SaintGimp/UselessBox/UselessBox.brd

## EAGLE design UselessBox.brd (2015-03-20)

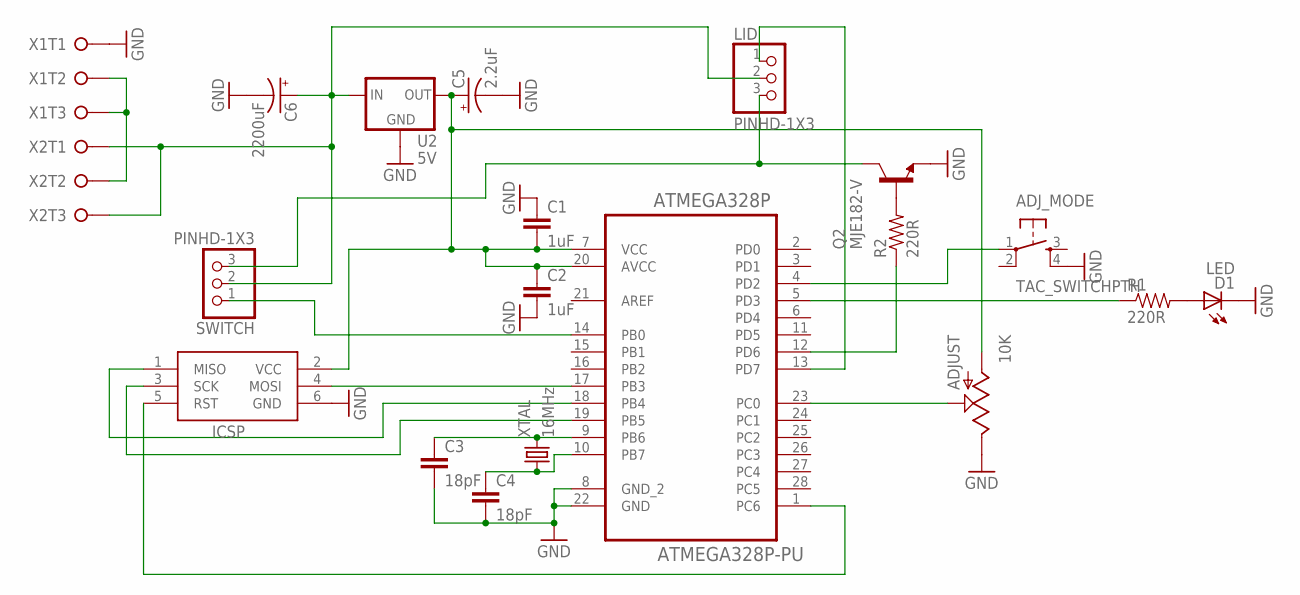
[picture p1: schematic UselessBox.sch]

Parts:
ADJUST: 10K; POT-3362U
ADJ_MODE: TAC_SWITCHPTH; TACTILE-SWITCH-6MM
ATMEGA328P: ATMEGA328P-PU; DIP28
C1, C2: 1uF; CAPACITOR-5MM
C3, C4: 18pF; CAPACITOR-2.5MM
C5: 2.2uF; CAP-POL-2.5-5
C6: 2200uF; CAP-POL-5-10
D1: LED; LED5MM
ICSP: AVRISP-6; AVRISP
LID: PINHD-1X3; 1X03
Q2: MJE182-V; TO225AA-V
R1, R2: 220R; AXIAL-7.5MM
SWITCH: PINHD-1X3; 1X03
U2: 5V; TO92-INLINE
X1, X2: SCREW-TERM-3
XTAL: 16MHz; CRYSTAL-V

Connections:
GND: ADJUST.P$1 (E), ADJ_MODE.4, ATMEGA328P.8 (GND_2), ATMEGA328P.22 (GND), C1.1, C2.2, C3.2, C4.2, C5.-, C6.-, D1.K (C), ICSP.6 (GND), Q2.E, U2.2 (GND), X1.1
unnamed: ATMEGA328P.13 (PD7), LID.1
unnamed: ADJ_MODE.1, ATMEGA328P.4 (PD2)
unnamed: ATMEGA328P.19 (PB5), ICSP.3 (SCK)
unnamed: ATMEGA328P.18 (PB4), ICSP.1 (MISO)
unnamed: ATMEGA328P.17 (PB3), ICSP.4 (MOSI)
unnamed: ATMEGA328P.1 (PC6), ICSP.5 (RST)
unnamed: ATMEGA328P.14 (PB0), SWITCH.1
unnamed: ATMEGA328P.9 (PB6), C3.1, XTAL.2
unnamed: ATMEGA328P.10 (PB7), C4.1, XTAL.1
unnamed: ATMEGA328P.12 (PD6), R2.P$1 (1)
unnamed: LID.3, Q2.C, SWITCH.3
unnamed: X1.2, X1.3, X2.2
unnamed: ADJUST.P$2 (S), ATMEGA328P.23 (PC0)
unnamed: Q2.B, R2.P$2 (2)
unnamed: D1.A, R1.P$2 (2)
unnamed: ATMEGA328P.5 (PD3), R1.P$1 (1)
VCC: ADJUST.P$3 (A), ATMEGA328P.7 (VCC), ATMEGA328P.20 (AVCC), C1.2, C2.1, C5.+, ICSP.2 (VCC), U2.1 (OUT)
VIN: C6.+, LID.2, SWITCH.2, U2.3 (IN), X2.1, X2.3

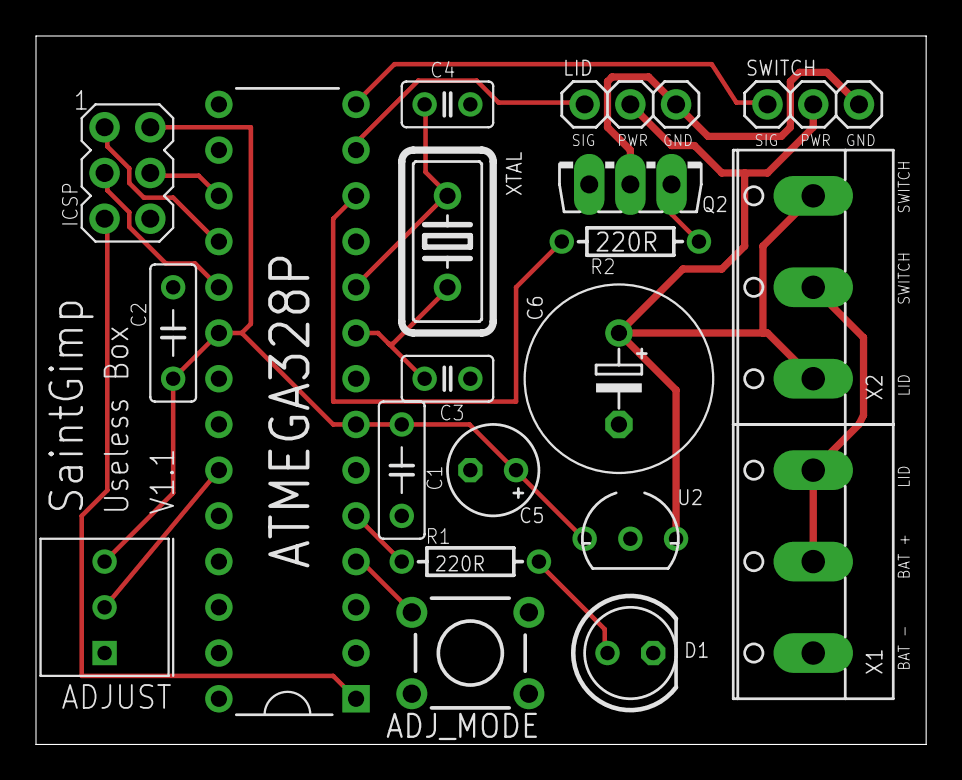
[picture p2: board UselessBox.brd from above]

Board: 2 copper layers, 49.5 x 39.4 mm, 20 parts (0 on the bottom side), 19 nets.
