SaintGimp/UselessBox/UselessBox.ino

// Based on code at http://www.lamja.com/?p=451

// Fuses to wipe EEPROM on upload:
// avrdude -c usbtiny -p atmega328p -U lfuse:w:0xff:m -U hfuse:w:0xde:m -U efuse:w:0x05:m

// Fuses to prevent loss of EEPROM on upload:
// avrdude -c usbtiny -p atmega328p -U lfuse:w:0xff:m -U hfuse:w:0xd6:m -U efuse:w:0x05:m

#include <Servo.h> 
#include <EEPROM.h>
#include <avr/eeprom.h>
#include <Bounce2.h>

const int MODE_NORMAL = 0;
const int MODE_INSTALL_ARMS = 1;
const int MODE_ADJUST_LID = 2;
const int MODE_ADJUST_SWITCH = 3;
int mode = 0;

const int EEPROM_LID_FROM = 10;
const int EEPROM_SWITCH_TO = 20;
const int EEPROM_RANDOM_CONTEXT = 30;

const int switchServoPin = 8;
const int lidServoPin = 7;
const int buttonPin = 2;
const int ledPin = 3;
const int potPin = A0;

Bounce modeButton = Bounce();

Servo switchServo;
Servo lidServo;  
                 
int lidFrom = 0; // adjustable, loaded in setup
int lidTo = 1850; // fixed
int lidRange = 0;

int switchFrom = 1800; // fixed
int switchTo = 0; // adjustable, loaded in setup
int switchRange = 0;

unsigned long randomContext;

void setup() 
{ 
  pinMode(6, OUTPUT);  // turn off motor power for startup
  digitalWrite(6, LOW);

  pinMode(ledPin, OUTPUT);
  digitalWrite(ledPin, LOW);

  int schema = EEPROM.read(511);
  if (schema == 87)
  {
    EEPROM.get(EEPROM_LID_FROM, lidFrom);
    EEPROM.get(EEPROM_SWITCH_TO, switchTo);
  }
  else
  {
    // If we haven't run on the MCP before, set the end points
    // of the motor travel equal to the start point and the user
    // will need to do the adjust routine to set them so there's motion.
    lidFrom = lidTo;
    EEPROM.put(EEPROM_LID_FROM, lidFrom);
    switchTo = switchFrom;
    EEPROM.put(EEPROM_SWITCH_TO, switchTo);
    EEPROM.write(511, 87);
  }
  lidRange = lidTo - lidFrom;
  switchRange = switchFrom - switchTo;
  
  switchServo.attach(switchServoPin);
  lidServo.attach(lidServoPin);
  switchServo.write(switchFrom);
  lidServo.write(lidFrom);
  
  pinMode(buttonPin, INPUT_PULLUP);     
  modeButton.attach(buttonPin);
  modeButton.interval(100);
  
  delay(100);
  digitalWrite(6, HIGH);  // turn on motor power
}  

void loop() 
{ 
  modeButton.update();
  if (modeButton.fell())
  {
    mode = ++mode % 4;

    if (mode == MODE_NORMAL)
    {
      // Leaving MODE_ADJUST_SWITCH
      EEPROM.put(EEPROM_SWITCH_TO, switchTo);
      
      digitalWrite(ledPin, LOW);
    }
    
    if (mode == MODE_INSTALL_ARMS)
    {
      digitalWrite(ledPin, HIGH);
    }

    if (mode == MODE_ADJUST_LID)
    {
      digitalWrite(ledPin, LOW);
      delay(500);
      digitalWrite(ledPin, HIGH);
    }

    if (mode == MODE_ADJUST_SWITCH)
    {
      // Leaving MODE_ADJUST_LID
      EEPROM.put(EEPROM_LID_FROM, lidFrom);

      // Move the lid arm off the switch so we don't shut ourselves off
      lidServo.writeMicroseconds(lidFrom + 200);
      
      digitalWrite(ledPin, LOW);
      delay(500);
      digitalWrite(ledPin, HIGH);
    }
  }
  
  if (mode == MODE_NORMAL)
  {
    RunSequence();
  }

  if (mode == MODE_INSTALL_ARMS)
  {
    InstallArms();
  }

  if (mode == MODE_ADJUST_LID)
  {
    AdjustLid();
  }

  if (mode == MODE_ADJUST_SWITCH)
  {
    AdjustSwitch();
  }
}

void RunSequence()
{
  int sequence = GetRandomNumber(25);

  if (sequence == 0) Sequence0();
  if (sequence == 1) Sequence1();
  if (sequence == 2) Sequence2();
  if (sequence == 3) Sequence3();
  if (sequence == 4) Sequence4();
  if (sequence == 5) Sequence5();
  if (sequence == 6) Sequence6();
  if (sequence == 7) Sequence7();
  if (sequence == 8) Sequence8();
  if (sequence == 9) Sequence9();
  if (sequence == 10) Sequence10();
  if (sequence == 11) Sequence11();
  if (sequence > 11) DefaultSequence();
    
  delay(2000);
}

int GetRandomNumber(int max)
{
  // We can get the random context, save it, and load it again next
  // time so that we don't have to worry about generating a new random
  // seed every time from hardware.  That seems to give us much better
  // distributions than trying to read a floating analog pin, etc.
  
  unsigned long randomContext = eeprom_read_dword(EEPROM_RANDOM_CONTEXT);
  int sequence = random_r(&randomContext) % max;
  eeprom_write_dword(EEPROM_RANDOM_CONTEXT, randomContext);
  return sequence;
}

void InstallArms()
{
  lidServo.writeMicroseconds(lidTo);
  switchServo.writeMicroseconds(switchFrom);
}

void AdjustLid()
{
  lidFrom = lidTo - analogRead(potPin);
  lidServo.writeMicroseconds(lidFrom);
}

void AdjustSwitch()
{
  switchTo = switchFrom - analogRead(potPin);
  switchServo.writeMicroseconds(switchTo);
}

// Plain old open the lid, press the switch, close the lid
void DefaultSequence()
{
  Sweep(lidServo, lidFrom, lidTo, 1);
  delay(100);
  Sweep(switchServo, switchFrom, switchTo, 1);
  delay(275);
  Sweep(switchServo, switchTo, switchFrom, 1);
  delay(120);
  Sweep(lidServo, lidTo, lidFrom, 1);
}

void Sequence0()
{
  int lidMid = lidFrom  + lidRange * 0.80;
  int lidMid4 = lidFrom  + lidRange * 0.60;
  int switchMid = switchTo + switchRange * 0.57;

  Sweep(lidServo, lidFrom, lidMid, 3000);
  delay(1000);
  Sweep(lidServo, lidMid, lidMid4, 500);
  delay(1000);
  Sweep(lidServo, lidMid4, lidTo, 1000);
  Sweep(switchServo, switchFrom, switchMid, 1800);
  Sweep(switchServo, switchMid, switchTo, 500);
  delay(110);
  Sweep(switchServo, switchTo, switchFrom, 500);
  Sweep(lidServo, lidTo, lidFrom, 500);
}

void Sequence1()
{
  int lidMid = lidFrom  + lidRange * 0.90;
  int lidMid2 = lidFrom + lidRange * 0.68;
  int lidMid3 = lidFrom + lidRange * 0.77;
  int lidMid4 = lidFrom  + lidRange * 0.60;
  int switchMid = switchTo + switchRange * 0.57;

  Sweep(lidServo, lidFrom, lidMid2, 3000);
  Sweep(lidServo, lidMid2, lidMid3, 1);
  delay(100);
  Sweep(lidServo, lidMid3, lidMid2, 1);
  delay(90);
  Sweep(lidServo, lidMid2, lidMid3, 1);
  delay(90);
  Sweep(lidServo, lidMid3, lidMid2, 1);
  delay(90);
  Sweep(lidServo, lidMid2, lidMid3, 1);
  delay(90);
  Sweep(lidServo, lidMid3, lidMid2, 1);
  delay(300);
  Sweep(lidServo, lidMid2, lidMid4, 3000);
  Sweep(lidServo, lidMid4, lidMid, 3000);
  delay(1000);
  Sweep(lidServo, lidMid, lidTo, 1000);
  Sweep(switchServo, switchFrom, switchMid, 1800);
  Sweep(switchServo, switchMid, switchTo, 200);
  delay(110);
  Sweep(switchServo, switchTo, switchFrom, 200);
  Sweep(lidServo, lidTo, lidFrom, 500);
}

void Sequence2()
{
  int switchMid2 = switchTo + switchRange * 0.28;   // Almost on the switch

  Sweep(lidServo, lidFrom, lidTo, 1);
  delay(1);
  Sweep(switchServo, switchFrom, switchMid2, 1);
  delay(450);
  Sweep(switchServo, switchMid2, switchTo, 30000);
  delay(100);
  Sweep(switchServo, switchTo, switchFrom, 1);
  delay(120);
  Sweep(lidServo, lidTo, lidFrom, 1);
}

void Sequence3()
{
  int switchMid2 = switchTo + switchRange * 0.10;   // Almost on the switch

  Sweep(lidServo, lidFrom, lidTo, 1);
  delay(100);
  Sweep(switchServo, switchFrom, switchTo, 1);
  delay(60);
  Sweep(switchServo, switchTo, switchMid2, 1);
  delay(60);
  Sweep(switchServo, switchMid2, switchTo, 1);
  delay(60);
  Sweep(switchServo, switchTo, switchMid2, 1);
  delay(60);
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
  Sweep(switchServo, switchMid2, switchTo, 1);
  delay(2000);
  Sweep(switchServo, switchTo, switchFrom, 2000);
  delay(200);
  Sweep(lidServo, lidTo, lidFrom, 1);
}

void Sequence11()
{
  int switchMid1 = switchTo + switchRange * 0.60;
  int switchMid2 = switchTo + switchRange * 0.30;

  Sweep(switchServo, switchFrom, switchMid1, 1000);
  delay(2000);
  Sweep(switchServo, switchMid1, switchFrom, 1);
  delay(1000);
  Sweep(switchServo, switchFrom, switchMid2, 1000);
  delay(2000);
  Sweep(switchServo, switchMid2, switchMid1, 6000);
  delay(2000);
  Sweep(lidServo, lidFrom, lidTo, 1);
  delay(100);
  Sweep(switchServo, switchMid1, switchTo, 1);
  delay(250);
  Sweep(switchServo, switchTo, switchFrom, 1);
  delay(120);
  Sweep(lidServo, lidTo, lidFrom, 1);
}

void Sweep(Servo& servo, int from, int to, int usec)  
{
  if (from <= to)
  {
    for (int pos = from; pos < to; pos++)
    {
      servo.writeMicroseconds(pos);
      delayMicroseconds(usec);
    }
  }
  else
  {
    for (int pos = from; pos >= to; pos--)
    {
      servo.writeMicroseconds(pos);
      delayMicroseconds(usec); 
    }
  }
}
