SaintGimp/UselessBox/(commit log)

2015-03-17 Increase strength of arm/shaft interface
2015-03-17 Controller board
    [UselessBox.brd, UselessBox.sch]
2015-03-18 Better power traces and polish tweaks
    [UselessBox.brd]
2015-03-20 Update size of bypass caps
    [UselessBox.brd, UselessBox.sch]
2015-03-20 Update parts from library
    [UselessBox.brd, UselessBox.sch]
2015-04-29 Tweak patterns and add a couple new ones
2017-03-03 Update laser cutting file for the box
